mertakozcan/atto-robot/README.md

# atto-robot
University of Washington EE/CSE 474 (Embedded Systems) Autumn 17 Quarter Project

## Team Members
* Andrew Comstock
* Mert Akozcan
* Zhuoming Zhang
* Cloe Lee

Please see https://github.com/mertakozcan/atto-robot/blob/master/Atto_Report.pdf for the complete report of the project.
