mertakozcan/atto-robot/hardware/robot_brain.h

//
// Created by Mert Akozcan on 11/26/17.
//

#ifndef ROBOT_BRAIN_H
#define ROBOT_BRAIN_H

#include "motor_controller.h"
#include "distance_controller.h"
#include "uart_controller.h"

class RobotBrain {

public:
  RobotBrain() {
    motorController = new MotorController();
    distanceController = new DistanceController();
    uartController = new UARTController();
  }
  
  ~RobotBrain() {
    delete motorController;
    delete distanceController;
    delete uartController;
  }

  void Work();

protected:
  MotorController *motorController;
  DistanceController *distanceController;
  UARTController *uartController;
};

#endif //ROBOT_BRAIN_H
