mertakozcan/atto-robot/(commit log)

2017-11-27 Add distance sensor code
2017-11-28 Configure GPIO Port D to control motor direction
2017-11-28 Fix an ADC bug
    [distance_controller.cpp]
2017-11-30 Improve general design and calibrate motors
2017-12-01 Integrate UART (Bluetooth)
2017-12-05 Add user control and fix bugs
    [distance_controller.cpp, distance_controller.h, motor_controller.cpp, motor_controller.h, robot_brain.cpp, robot_brain.h]
2017-12-09 Implement data transfer between app and board
